MikAmperka/articles/(list of files, cad)

Other CAD files:
how-to-make-an-old-school-neon-street-sign/files/drawing-dwg.dwg
